adamgreig/agg-kicad/3d/J1011F01PNL_3D.STEP

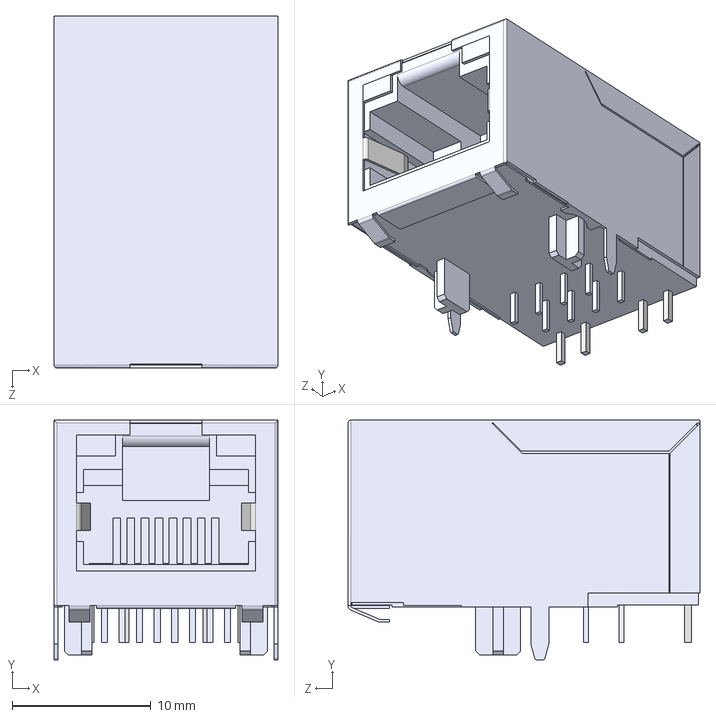
[picture p1: CAD file, 2024-02-22]
3d/J1011F01PNL_3D.STEP
16.2 x 17.3 x 25.4 mm
