adamgreig/agg-kicad/(threads)

Thread 1 (2015-11-08):

Add basic symbols

adamgreig, 2015-11-08:
Add basic commonly used symbols
 - [x] Power nets
 - [x] RCLs
 - [x] LEDs
 - [x] Xtals
 - [x] Range of connectors

Closed 2015-12-24.

Thread 3 (2015-11-08):

Ensure all footprints follow standard conventions

adamgreig, 2015-11-08:

seppestas, 2019-05-28:
Maybe it's interesting to look into the KLC (KiCad Library Convention). There is tools to check for it here: https://github.com/KiCad/kicad-library-utils

Thread 6 (2015-12-22):

Autogenerate HTML/MD table of parts

adamgreig, 2015-12-22:
Instead of current manually edited READMEs, generate a nice HTML or Markdown page with...

* All parts, categorised
* Details such as name, designator, footprint, order code
* Results of error checker (should all be ticks of course!)
* Notes currently in README including if it's been checked in production
* Description from .dcm file perhaps

Thread 17 (2016-01-03):

USB connector

adamgreig, 2016-01-03:
* Find a better way to do the shield pins so they don't want to be connected together
* Try swapping to plated slots for the side mounts
* Remove side pads from bottom mask layer
* Update to MOLEX's revised recommended footprint

adamgreig, 2016-01-03:
Only one shield pin now on the net by default. Most of the time this is fine (the pins are all connected on the component so only attaching at one point is fine anyway; you can edit the pin nets in the PCB if needed also).

Plated slots done. Hope they work.

Side pads now plated slots so not on bottom mask anywhere except where they must be.

Updated to revised footprint.

Closed 2016-01-03.

Thread 18 (2016-01-07):

Have panelise add extras

adamgreig, 2016-01-07:
* Tabs connecting step-repeated boards
* Panel outline
* Panel tooling holes
* Those weird calibration strip things?
* Alignment targets

Thread 21 (2016-01-24):

Create a label BoM

adamgreig, 2016-01-24:
Create print-out stickers for each bag of parts that show the designators, footprint/part/etc, and a drawing of the PCB with the placement (inc pin1) highlighted. Would make assembly much more convenient!

adamgreig, 2016-02-06:
Done! :tada:

Closed 2016-02-06.

Thread 30 (2016-02-08):

StickerBOM doesn't support circular PCBs on Edge.Cuts

adamgreig, 2016-02-08:

Closed 2016-02-08.

Thread 34 (2016-02-08):

agg-kicad.pro build problem on Windows

Wizongod, 2016-02-08:
The Library paths in agg-kicad.pro have Windows' back-slashes `\` mixed in instead of the normal slashes `/`. This also results in a problem when opening up in KiCad.

Closed 2016-02-08.

Thread 36 (2016-02-13):

Create incomplete outputs

ok1hra, 2016-02-13:
Error messages:
Traceback (most recent call last):
  File "/home/dan/kicad/agg-kicad-master/scripts/stickerbom.py", line 454, in <module>
    main(xmlpath, pdfpath)
  File "/home/dan/kicad/agg-kicad-master/scripts/stickerbom.py", line 446, in main
    label_height-14, line.refs)
  File "/home/dan/kicad/agg-kicad-master/scripts/stickerbom.py", line 208, in render
    scale_x = max_w / bound_width
ZeroDivisionError: float division by zero

[bd.pdf](https://github.com/adamgreig/agg-kicad/files/128887/bd.pdf)

adamgreig, 2016-02-13:
Do you have an example file that's causing this problem? My guess is it's finding the required bounding area around components is zero width, causing problems.

ok1hra, 2016-02-13:
if anything is missing, i add

[bd.zip](https://github.com/adamgreig/agg-kicad/files/128890/bd.zip)

adamgreig, 2016-03-12:
Hi @ok1hra, thanks for the bug report! I'm sorry it took a while to get around to fixing it. The problem was that P13 has just the one pad, and when its extent was computed, the pad's size was not taken into account, so it had a zero-sized highlight area, which caused the problem.

I've updated StickerBOM to include the size of the pads when computing the extents, so the problem should now be fixed - and seems to work fine on your PCB.

ok1hra, 2016-03-17:
Thanks for fix it, now generate without errors.
But otputs pile up in one page [bd.pdf](https://github.com/adamgreig/agg-kicad/files/177464/bd.pdf).

adamgreig, 2016-03-17:
Please try with `python3` instead of `python`, sounds like you are experiencing issue #45

ok1hra, 2016-03-18:
Confirming you're right, now works correctly, thanks again.

Closed 2016-03-12.

Thread 44 (2016-03-10):

sexp not behaving well

cchamilt, 2016-03-10:
```
Traceback (most recent call last):
  File "agg-kicad/scripts/stickerbom.py", line 454, in <module>
    main(xmlpath, pdfpath)
  File "agg-kicad/scripts/stickerbom.py", line 429, in main
    pcb = PCB(sexp.parse(f.read()))
  File "agg-kicad/scripts/stickerbom.py", line 185, in __init__
    self._parse(board)
  File "agg-kicad/scripts/stickerbom.py", line 296, in _parse
    self.modules.append(Module(module))
  File "agg-kicad/scripts/stickerbom.py", line 47, in __init__
    self._parse(mod)
  File "agg-kicad/scripts/stickerbom.py", line 126, in _parse
    self._parse_pad(pad)
  File "agg-kicad/scripts/stickerbom.py", line 151, in _parse_pad
    layers = sexp.find(pad, "layers")[1]
IndexError: list index out of range
```
When I wrap  sexp.find(pad, "layers") usage with a len check, I get a blank 11 page pdf.

adamgreig, 2016-03-10:
Do you have an example .kicad_pcb file that triggers this behaviour?

cchamilt, 2016-03-11:
For this project it would require an NDA as the design isn't mine to share.  Would that be OK?

adamgreig, 2016-03-12:
That is OK if necessary, though if you can isolate what's causing the problem perhaps that would be easier. Could you try adding `print(pad)` to the top of `_parse_pad` and see what the output is? It looks like probably one of the pads in your board does not have _any_ layers which is a bit unusual so might be a parsing issue.

cchamilt, 2016-03-12:
Ah, OK.  I would guess there are some old patterns with through-holes that were set to no layers instead of npth.  I'll add the print and review them.  Hopefully that is the fix.

cchamilt, 2016-03-13:
I went through and located the bad npth.  So everything has layers and the script finishes, but still seems that the pdf is blank.  I'll get you a copy of the NDA asap.

adamgreig, 2016-03-13:
Okay, thanks. Crashing with no layers is obviously still a bug but good to
know that was the cause of the exception.

Are you using Python 2 and if so could you try with Python 3? Should work
with both but is the root of another pdf rendering bug I'm chasing down.

cchamilt, 2016-03-19:
Yeah, I can confirm it doesn't render in either version of python.

Thread 45 (2016-03-11):

StickerBOM disagrees with Teapot

cillian64, 2016-03-11:
StickerBOM does terrible things when exposed to [my "teapot" board](https://github.com/cillian64/teapot/tree/master/board) - it seems like p1 of the output gets moved to and overlayed onto p2.

adamgreig, 2016-03-12:
Works fine in Python 3, issue seems to be in Python 2. Can't spot any obvious issue...

ch-aurich, 2016-03-26:
the problem is the way you generate the label positions... I added some debug outputs to see what happens in my script (until now I added the stickerbom feature only to the development branch: https://github.com/I2SE/eagle-bom.py/tree/develop):

python2 first generates all label positions in function sheet_positions (is initiated by function "zip") and then adds content to them... python3 initiates the generation of the label positions when they are used.

I will try to fix this issue in my script and then will suggest the solution to you as a pull request.

adamgreig, 2016-03-26:
ah, of course, thanks! I think just swapping to the generator zip in `itertools.izip` should solve it.

ch-aurich, 2016-03-27:
just using itertools.izip did not work for me with python 3.x therefore I implemented it a bit different... you can have a look at http://codereview.stackexchange.com/questions/26271/cleaner-way-to-import-izip-for-different-versions-of-python where I found this solution to be the most elegant...

adamgreig, 2016-03-27:
Fixed by #46

Closed 2016-03-27.

Thread 58 (2016-06-18):

3D Models

HarkonenBade, 2016-06-18:
Would it be possible to either add 3D models for parts, or at least for standard things like 0603/1206 style packages to reference the standard kicad library models for those parts?

adamgreig, 2016-06-18:
It would be really nice! I'm holding out on KiCAD supporting more 3d formats first, as the current format is a quite weird Wings3D thing whereas work is underway to support STL and other formats, at which point most parts can be downloaded from the manufacturer and the rest can be defined in text easily.

It might be relatively easy to refer to existing KiCAD 3d parts (eg an extra optional field in `build_mod_chip.py` and `build_mod_ic.py`) but I've not looked in to it yet...

HarkonenBade, 2016-07-11:
I've started collating some of my work on bits like this in https://github.com/HarkonenBade/kicad-models

Unfortunately I think until kicad supports more reasonable model formats, or someone writes a VRML exporter targeted at kicad, I don't think programmatic generation of models is going to be reasonable. Also I've been using openscad for a lot of stuff and really it needs better support for specifying colors/materials of objects.

So for now I would set this issue to awaiting upstream changes.

Thread 67 (2016-07-01):

Add an arg to which field to print instead of "supplier":"number"

metropt, 2016-07-01:
Hi,
Thank you for the work doing the script :)

I don't usually have the supplier on the part. Only the manf. part number which I call "manf#" because I use [KiCost](https://kicost.readthedocs.io/en/latest/readme.html) to generate the BOM with prices, etc...

So to use your code I needed to comment the condition on line 473 which works nice :) I would be able to create the PDF however the supplier field doesn't print the same value on all components but some random field.

It would be nice to be able to select the field you want to use.

I'll try to do that.

HarkonenBade, 2016-07-01:
You might want to take a look at #66

metropt, 2016-07-01:
Thank you, edited supplier_to_output and add only manf# solved my problem!

adamgreig, 2016-07-02:
Great, glad to hear you've worked it out. Once #66 lands you can do it from the command line in KiCAD without editing the script at all which will be nice.

Closed 2016-07-02.

Thread 77 (2016-09-18):

GitHub integration to show new symbols and footprints

adamgreig, 2016-09-18:
Make a neat service that sees new pull requests, notices if there are any new .yaml or .kicad_mod files, and if so, renders them and comments with a picture.

seppestas, 2019-05-28:
I was planning to add this sort of functionality to https://github.com/productize/kicad-file-render-service. Let me know if you are still interested in this use-case.

Thread 87 (2016-11-02):

microusb part has VCC as power input

cillian64, 2016-11-02:
The part is actually a microusb AB, where VCC could be a power input or output, so "passive" might be most correct.

Alternatively, since this part is almost always used as a type B in practice, power output would probably be the most helpful choice, and anybody actually using OTG can change it.

Closed 2016-11-07.

Thread 103 (2017-03-30):

TPS62152 PG should be open drain, not output

cillian64, 2017-03-30:
Causes ERC error when pulling PG to ground, as is recommended when PG is unused.

Closed 2017-03-30.

Thread 108 (2017-05-08):

Autogenerate mechanical holes and mounting holes

adamgreig, 2017-05-08:
Replace M2.5_HOLE, M2.5_MOUNT, M3_HOLE, and M3_MOUNT with autogenerated holes in a wider range of sizes and styles.

See #106 for earlier discussion.

Thread 121 (2017-08-22):

Don't store built artifacts in the repository

russss, 2017-08-22:
Dealing with multiple pull requests is rather a pain at the moment because pretty much all PRs include unmergeable changes to the `agg-kicad.[lib|pro]` files.

It would be much easier to deal with this stuff if these generated files weren't stored in the repo. Here's one way this could be done fairly easily:

* Alter the build scripts so that the generated libraries live in a separate directory tree.
* Either:
     * Manually tag a release periodically after merging PRs, or,
     * Make the travis script automatically tag a new release when a build succeeds on master.
* Set up travis so tag builds are [uploaded as GitHub releases](https://docs.travis-ci.com/user/deployment/releases/)

This means that the generated libraries can be downloaded as .zip files (which is probably more convenient for most users), and those who are working off the git tree won't be constantly plagued with merge conflicts.

adamgreig, 2017-08-22:
I'm not sure what the best way to deal with this is. Almost all of my own use cases, and many others I know about, have agg-kicad as a git submodule in their own repository, which makes it easy to keep up-to-date, but then they only use that submodule for the `agg.pretty` directory and `agg-kicad.lib` top level library that contains every part.

In addition to being annoying because those build artifacts change, a lot of users want some of the library parts (ICs etc) without others (the agg-kicad R, C, L, and power symbols). So there was some thought to having separate build artifacts for different collections.

I wonder if another repository that only contains up-to-date build artifacts is the way to go, automatically maintained by Travis?

HarkonenBade, 2017-08-22:
Yeah, I'd suspect that the best way to handle it is with one repo (say `agg-kicad-src`) that contains all the current code and yaml and a second repo (say `agg-kicad`) that contains only the built artifacts and is only ever pushed to by a travis script that runs on new commits to the master of the src repo.

seppestas, 2019-05-28:
I think using a second repo or maybe an orphaned brach to store the build results sounds like a good idea. This would also make it a bit easier / cleaner to include the build artifacts as a submodule.

Thread 138 (2019-05-02):

Generate sym-lib-table now that kicad doesn't use the .pro to list libraries

adamgreig, 2019-05-02:

Closed 2020-04-14.

Thread 141 (2019-11-25):

Recommended Practice - NC but groundable

HarkonenBade, 2019-11-25:
What should be the recommended practice for symbols that have pins which are officially declared as N/C but that the data sheet suggests may be grounded or left floating as desired?

HarkonenBade, 2019-11-26:
e.g. pins 3, 4 and 5 on the MCP1810 ( http://ww1.microchip.com/downloads/en/DeviceDoc/20005623A.pdf)

Thread 143 (2019-11-30):

3D models have all moved

russss, 2019-11-30:
Unless I'm completely mistaken, the 3D models we reference have moved locations in new(ish) versions of KiCAD... e.g.:

`Housings_SOIC.3dshapes` is now `Package_SO.3dshapes`
`Resistors_SMD.3dshapes` is now `Resistor_SMD.3dshapes`

But worse, the name of the actual files has also changed in many cases. This seems to have happened back in Feb 2018.

adamgreig, 2019-11-30:
Yep, it's pain... Most of them will have to be updated by hand I think. I'm also not convinced defaulting to resistors for all chip components is the best bet, but I don't really want to split each size into resistor vs capacitor footprints. On the other hand, maybe it would allow different silk for each and perhaps slightly different pad geometries...

Also, for a lot of parts there are no models in KiCAD itself, but there are manufacturer supplied models, which might be worth including in the repo.

adamgreig, 2019-11-30:
On the whole I think the project needs a bit of TLC; I still use it exclusively for all my PCB designs but my impression is that the stock KiCAD libraries are much higher quality today than when I started agg-kicad, so I think other people probably have less need for it. That said, I think the scripted symbol and footprint generation is still really useful. I wonder if it's worth rejigging to make it easier to use the generator scripts or generated parts individually (perhaps part of #121 or something), or something else.

HarkonenBade, 2019-12-01:
I'm still a big fan of the library in general and have been using it myself for a recent major project. I agree that the stock libraries seem to be improving dramatically, but I do find the scripted yaml generation to be the best way to throw together new parts quickly and accurately.
I'd be very in favour of seeing a setup where a given project has a single yaml (or maybe a small local directory of them) that can be run through a single script to generate a symbol library and footprint library of parts for that project. Particularly it might be interesting at looking at integrating the library and footprint generation. Given it's not entirely unusual to be generating new QFN/DFN variants for specific ICs, and it may be nice to be able to actively just place the footprint definition inside the library symbol definition for that specific part.

Also back on the models, I have some current updates that i can upstream to restore some of the models, and I had a little work on scripted model generation that was abandoned at the time due to kicad's limited model types support, but may now be worth renewing.

Gasman2014, 2019-12-01:
Would https://github.com/qeda/qeda be a suitable scriptable yaml generator?

Thread 148 (2022-10-18):

Does stickerbom work in KiCad 6.0?

Phozer, 2022-10-18:
First of all, great Project!

I tried using the stickerbom.py to create labels to stick on my component bags. I face some problems using it, so I want to ask if it even works with KiCad 6.0?

This is what i get as output.
```
python C:\03_Data\repos_external\git\agg-kicad\scripts\stickerbom.py C:\03_Data\repos\SVN\TestAutomation\TestAdapter\SNIFX\SNIFX.QP2\2_KiCad\SNIFX.xml C:\03_Data\repos\SVN\TestAutomation\TestAdapter\SNIFX\SNIFX.QP2\2_KiCad
Traceback (most recent call last):
  File "C:\03_Data\repos_external\git\agg-kicad\scripts\stickerbom.py", line 589, in <module>
    main()
  File "C:\03_Data\repos_external\git\agg-kicad\scripts\stickerbom.py", line 534, in main
    pcb = PCB(sexp.parse(f.read()))
  File "C:\03_Data\repos_external\git\agg-kicad\scripts\stickerbom.py", line 166, in __init__
    self._parse(board)
  File "C:\03_Data\repos_external\git\agg-kicad\scripts\stickerbom.py", line 306, in _parse
    min(m.at[0] for m in self.modules),
ValueError: min() arg is an empty sequence
```

adamgreig, 2022-10-18:
Thanks for opening the issue! It looks like KiCad 6 made a few changes that broke stickerbom, mostly renaming "modules" to "footprints" in the board file and changing how graphic arcs are represented from "centre, start, angle" to "centre, mid, end". I've just pushed an update to stickerbom that seems to work for me on some KiCad 6 boards, could you check if it works for you?

Phozer, 2022-10-19:
Thanks for your quick fix.
Seems to work much better than before.
Now i have this issue:
```
C:\03_Data\repos_external\git\agg-kicad\scripts>python stickerbom.py C:\03_Data\repos\SVN\TestAutomation\TestAdapter\SNIFX\SNIFX.QP2\2_KiCad\SNIFX.xml C:\03_Data\repos\SVN\TestAutomation\TestAdapter\SNIFX\SNIFX.QP2\2_KiCad\stickerBOM.pdf
Traceback (most recent call last):
  File "C:\03_Data\repos_external\git\agg-kicad\scripts\stickerbom.py", line 600, in <module>
    main()
  File "C:\03_Data\repos_external\git\agg-kicad\scripts\stickerbom.py", line 596, in main
    cr.show_page()
__main__.cairo.MemoryError: out of memory
```
I tried with different boards. A PDF gets created but it's blank.

adamgreig, 2022-10-19:
Hm, that's odd. It seems like this might be an issue with PyCairo on Windows, see https://github.com/pygobject/pycairo/issues/239. Perhaps you could try the builds linked there, or a Linux/WSL build?

Phozer, 2022-12-05:
Do you have e public project which worked for you? Then I can check for differences and troubleshoot. Would love to get this to work.

Phozer, 2022-12-06:
Is there an option to uses the copper layer instead of the fab layer for the drawings?

adamgreig, 2022-12-08:
Ah cool, glad you figured it out! There's not a built-in option at the moment, but if you change `F.Fab` for `F.Cu` and `B.Fab` for `B.Cu` on lines 579-593 that should do it; currently it uses F.Fab first but if a footprint doesn't have any items on the fab layer it will instead render use the copper and silkscreen layers.

Phozer, 2022-12-16:
I will now close this Issue because for me it's fixed now. I just noticed that my Board outline did not get drawn. Just if you bother you may fix that. Thanks for your work. It helped a lot.

adamgreig, 2022-12-19:
Thanks for sticking with it, I'm glad it's working for you now! Not sure what's up with the board outline, I'll try and look into it.

Closed 2022-12-16.
