adamgreig/agg-kicad/mod/ic/msop-8-ep-ad.yaml

chip_shape: [3.1, 3.1]
description: |-
  MSOP-8 from JEDEC MO-187-AA-T, with EP, AD specific RH-8-1
  IPC-7351B: SOP65P490X110-9N
ep_shape: [1.725, 1.66]
ep_vias: [0.3, 0.65, 0.3]
model:
  offset: [0, 0, 0]
  path: ${KICAD8_3DMODEL_DIR}/Package_SO.3dshapes/MSOP-8_3x3mm_P0.65mm.step
  rotate: [0, 0, 0]
  scale: [1, 1, 1]
name: MSOP-8-EP-AD
pad_shape: [1.45, 0.45]
pin_pitch: 0.65
pin_shape: [1.0, 0.38]
pins: 8
row_pitch: 4.4
rows: 2
