adamgreig/agg-kicad/mod/ic/msop-8-ep-ltc.yaml

chip_shape: [3.1, 3.1]
description: |-
  MSOP-8 from JEDEC MO-187-AA-T, with EP, LT DWG 05-08-1662
  IPC-7351B: SOP65P490X110-9N
model:
  offset: [0, 0, 0]
  path: ${KICAD8_3DMODEL_DIR}/Package_SO.3dshapes/MSOP-8_3x3mm_P0.65mm.step
  rotate: [0, 0, 0]
  scale: [1, 1, 1]
ep_shape: [1.68, 1.88]
name: MSOP-8-EP-LTC
pad_shape: [1.2, 0.42]
pin_pitch: 0.65
pin_shape: [0.8, 0.38]
pins: 8
row_pitch: 4.4
rows: 2
