adamgreig/agg-kicad/mod/ic/qfn-16-ep-nxp.yaml

chip_shape: [3.0, 3.0]
description: |-
  HVQFN-16 from PCAL9538A
  IPC-7351B: QFN50P300X300X100-17N
ep_paste_shape: [0.3, 0.3, 0.31, 0.31]
ep_shape: [1.5, 1.5]
model:
  offset: [0, 0, 0]
  path: ${KICAD8_3DMODEL_DIR}/Package_DFN_QFN.3dshapes/QFN-16-1EP_3x3mm_P0.5mm_EP1.7x1.7mm.step
  rotate: [0, 0, 0]
  scale: [1, 1, 1]
name: QFN-16-EP-NXP
pad_shape: [0.9, 0.24]
pin_pitch: 0.5
pin_shape: [-0.4, 0.24]
pins: 16
row_pitch: 3.1
rows: 4
