adamgreig/agg-kicad/mod/ic/qfn-16-ep-skyworks.yaml

chip_shape: [3.0, 3.0]
description: |-
  QFN-16 from SKY65111-348LF datasheet
  For SKY65111-348LF
  IPC-7351B: QFN50P300X300X100-16N
ep_paste_shape: [0.7, 0.7, 0.3, 0.3]
ep_shape: [1.78, 1.78]
ep_vias: [0.3, 0.4, 0.2]
model:
  offset: [0, 0, 0]
  path: ${KICAD8_3DMODEL_DIR}/Package_DFN_QFN.3dshapes/QFN-16-1EP_3x3mm_P0.5mm_EP1.7x1.7mm.step
  rotate: [0, 0, 0]
  scale: [1, 1, 1]
name: QFN-16-EP-SKYWORKS
pad_shape: [0.78, 0.26]
pin_pitch: 0.5
pin_shape: [-0.3, 0.25]
pins: 16
row_pitch: 2.86
rows: 4
