adamgreig/agg-kicad/mod/ic/qfn-24-ep-max.yaml

chip_shape: [4.0, 4.0]
description: |-
  QFN-24 from MAXIM. Doc no. 21-0139
  For MAX17435
ep_mask_shape: [0.9, 0.9, 0.4, 0.4]
ep_paste_shape: [0.9, 0.9, 0.4, 0.4]
ep_shape: [2.6, 2.6]
model:
  offset: [0, 0, 0]
  path: ${KICAD8_3DMODEL_DIR}/Package_DFN_QFN.3dshapes/QFN-24_4x4mm_P0.5mm.step
  rotate: [0, 0, 0]
  scale: [1, 1, 1]
name: QFN-24-EP-MAX
pad_shape: [0.8, 0.3]
pin_pitch: 0.5
pin_shape: [-0.4, 0.23]
pins: 24
row_pitch: 3.91
rows: 4
