adamgreig/agg-kicad/mod/ic/qfn-24-ep-micrel.yaml

chip_shape: [4.0, 4.0]
description: |-
  QFN-24 from KSZ8081RNx datasheet
  For KSZ8081RNx
ep_mask_shape: [1.0, 1.0, 0.2, 0.2]
ep_paste_shape: [1.0, 1.0, 0.2, 0.2]
ep_shape: [2.6, 2.6]
ep_vias: [0.35, 0.5, 0.7]
name: QFN-24-EP-MICREL
pad_shape: [0.48, 0.23]
pin_pitch: 0.5
pin_shape: [-0.4, 0.25]
pins: 24
row_pitch: 3.72
rows: 4
model:
  offset: [0, 0, 0]
  path: ${KICAD8_3DMODEL_DIR}/Package_DFN_QFN.3dshapes/QFN-24_4x4mm_P0.5mm.step
  rotate: [0, 0, 0]
  scale: [1, 1, 1]
