adamgreig/agg-kicad/mod/ic/qfn-32-bgt24mtr.yaml

chip_shape: [4.5, 5.5]
description: VQFN32-9 for Infineon BGT24MTR family
ep_paste_shape: [1, 1, 0.5, 0.5]
ep_shape: [2.9, 3.9]
ep_vias: [0.3, 0.6, 0.7]
name: QFN-32-BGT24MTR
pad_shape: [0.85, 0.3]
pin_pitch: 0.5
pin_shape: [-0.55, 0.25]
pins: 32
pins_first_row: 10
row_pitch: [4.15, 5.15]
rows: 4
model:
  offset: [0, 0, 0]
  path: ${KICAD8_3DMODEL_DIR}/Package_DFN_QFN.3dshapes/QFN-32-1EP_5x5mm_P0.5mm_EP3.3x3.3mm.step
  rotate: [0, 0, 0]
  scale: [1, 1, 1]
