adamgreig/agg-kicad/mod/ic/qfn-32-ep-ti.yaml

chip_shape: [5.0, 5.0]
description: |-
  VQFN-32 from BQ40Z60
  IPC-7351B: QFN50P500X500X100-33N
ep_mask_shape: [3.45, 3.45, 0, 0]
ep_paste_shape: [1.45, 1.45, 0.3, 0.3]
ep_shape: [3.45, 3.45]
ep_vias: [0.3, 0.4, 1.0]
model:
  offset: [0, 0, 0]
  path: ${KICAD8_3DMODEL_DIR}/Package_DFN_QFN.3dshapes/QFN-32-1EP_5x5mm_P0.5mm_EP3.3x3.3mm.step
  rotate: [0, 0, 0]
  scale: [1, 1, 1]
name: QFN-32-EP-TI
pad_shape: [0.85, 0.28]
pin_pitch: 0.5
pin_shape: [-0.4, 0.25]
pins: 32
row_pitch: 4.95
rows: 4
