adamgreig/agg-kicad/mod/ic/sc-70-6.yaml

chip_shape: [1.4, 2.15]
description: |-
  SC-70-6
  JEDEC MO-203-AB
  IPC-7351B: SOT65P210X110-6N
model:
  offset: [0, 0, 0]
  path: ${KICAD8_3DMODEL_DIR}/Package_TO_SOT_SMD.3dshapes/SOT-363_SC-70-6.step
  rotate: [0, 0, 90]
  scale: [1, 1, 1]
name: SC-70-6
pad_shape: [0.95, 0.4]
pin_pitch: 0.65
pin_shape: [0.5, 0.3]
pins: 6
row_pitch: 2.2
rows: 2
