adamgreig/agg-kicad/mod/ic/soic-8-ep.yaml

chip_shape: [4.0, 5.0]
description: |-
  SOIC-8 from JEDEC MS-012AA, with exposed pad
  IPC-7351B: SOIC127P600X175-8N
ep_shape: [2.4, 3.1]
ep_vias: [0.3, 0.65, 0.3]
model:
  offset: [0, 0, 0]
  path: ${KICAD8_3DMODEL_DIR}/Package_SO.3dshapes/SOIC-8_3.9x4.9mm_P1.27mm.step
  rotate: [0, 0, 0]
  scale: [1, 1, 1]
name: SOIC-8-EP
pad_shape: [1.55, 0.6]
pin_pitch: 1.27
pin_shape: [1.1, 0.5]
pins: 8
row_pitch: 5.4
rows: 2
