adamgreig/agg-kicad/mod/ic/sot-323.yaml

chip_shape: [1.35, 2.1]
description: |-
  SOT-323
  IPC-7351B: SOT65P210X110-3N
model:
  offset: [0, 0, 0]
  path: ${KICAD8_3DMODEL_DIR}/Package_TO_SOT_SMD.3dshapes/SOT-323_SC-70.step
  rotate: [0, 0, -90]
  scale: [0.4, 0.4, 0.4]
name: SOT-323
pad_shape: [0.85, 0.55]
pin_pitch: 0.65
pin_shape: [0.4, 0.3]
pins: 6
row_pitch: 2.1
rows: 2
skip_pins: [2, 4, 6]
