adamgreig/agg-kicad/mod/ic/sot-666.yaml

chip_shape: [1.3, 1.7]
description: |-
  SOT-666
  IPC-7351B: SOTFL50P162X60-6N
  AKA SOT-563
  AKA SC-75-6
  AKA SC-89-6
name: SOT-666
pad_shape: [0.71, 0.3]
pin_pitch: 0.5
pin_shape: [0.35, 0.25]
pins: 6
row_pitch: 1.44
rows: 2
model:
  offset: [0, 0, 0]
  path: ${KICAD8_3DMODEL_DIR}/Package_TO_SOT_SMD.3dshapes/SOT-666.step
  rotate: [0, 0, 0]
  scale: [1, 1, 1]
