adamgreig/agg-kicad/mod/ic/tssop-14.yaml

chip_shape: [4.5, 5.1]
description: |-
  TSSOP-14 from JEDEC MO-153
  IPC-7351B: SOP65P640X120-14N
model:
  offset: [0, 0, 0]
  path: ${KICAD8_3DMODEL_DIR}/Package_SO.3dshapes/TSSOP-14_4.4x5mm_P0.65mm.step
  rotate: [0, 0, 0]
  scale: [1, 1, 1]
name: TSSOP-14
pad_shape: [1.35, 0.45]
pin_pitch: 0.65
pin_shape: [0.95, 0.3]
pins: 14
row_pitch: 5.75
rows: 2
