adamgreig/agg-kicad/mod/ic/tssop-20-ep.yaml

chip_shape: [4.5, 6.6]
description: |-
  TSSOP-20 from JEDEC MO-153AC with EP per LT3751
  IPC-7351B: SOP65P640X120-21N
ep_mask_shape: [2.2, 1.5, 0.0, 0.5]
ep_paste_shape: [2.2, 1.5, 0.0, 0.5]
ep_shape: [2.74, 3.86]
ep_vias: [0.4, 0.6, 0.5]
model:
  offset: [0, 0, 0]
  path: ${KICAD8_3DMODEL_DIR}/Package_SO.3dshapes/TSSOP-20_4.4x5mm_P0.5mm.step
  rotate: [0, 0, 0]
  scale: [1, 1, 1]
name: TSSOP-20-EP
pad_shape: [1.35, 0.45]
pin_pitch: 0.65
pin_shape: [0.95, 0.3]
pins: 20
row_pitch: 5.75
rows: 2
