adamgreig/agg-kicad/mod/ic/dfn-10-ep-max.yaml

chip_shape: [3.0, 3.0]
description: |-
  DFN-10 with EP
  For MAX5969x
ep_paste_shape: [1.2, 0.8, 0, 0.4]
ep_shape: [1.58, 2.35]
model:
  offset: [0, 0, 0]
  path: ${KISYS3DMOD}/Housings_DFN_QFN.3dshapes/DFN-10-1EP_3x3mm_Pitch0.5mm.wrl
  rotate: [0, 0, 0]
  scale: [1, 1, 1]
name: DFN-10-EP-MAX
pad_shape: [0.7, 0.3]
pin_pitch: 0.5
pin_shape: [-0.4, 0.25]
pins: 10
row_pitch: 2.95
rows: 2
