adamgreig/agg-kicad/mod/ic/dfn-16-ep-ltc-de.yaml

chip_shape: [3.1, 4.1]
description: |-
  DFN-16 from LTC4353
  IPC-7351B: DFN45P300X400X75-17N
ep_mask_shape: [0.8, 0.8, 0.2, 0.4]
ep_paste_shape: [0.8, 0.8, 0.2, 0.4]
ep_shape: [1.7, 3.3]
model:
  offset: [0, 0, 0]
  path: ${KISYS3DMOD}/Housings_DFN_QFN.3dshapes/DFN-16-1EP_3x4mm_Pitch0.45mm.wrl
  rotate: [0, 0, 0]
  scale: [1, 1, 1]
name: DFN-16-EP-LTC-DE
pad_shape: [0.7, 0.25]
pin_pitch: 0.45
pin_shape: [-0.41, 0.28]
pins: 16
row_pitch: 2.9
rows: 2
