adamgreig/agg-kicad/mod/ic/dfn-8-ep-ad.yaml

chip_shape: [3.1, 3.1]
description: |-
  DFN-8
  IPC-7351B: DFN50P300X300X75-9N
ep_mask_shape: [0.8, 0.8, 0, 0.4]
ep_paste_shape: [0.8, 0.8, 0, 0.4]
ep_shape: [1.8, 2.5]
model:
  offset: [0, 0, 0]
  path: ${KISYS3DMOD}/Housings_DFN_QFN.3dshapes/DFN-8-1EP_3x3mm_Pitch0.5mm.wrl
  rotate: [0, 0, 0]
  scale: [1, 1, 1]
name: DFN-8-EP-AD
pad_shape: [0.65, 0.35]
pin_pitch: 0.5
pin_shape: [-0.5, 0.3]
pins: 8
row_pitch: 3.1
rows: 2
