adamgreig/agg-kicad/mod/ic/dfn-8-ep-microchip.yaml

chip_shape: [3.1, 3.1]
description: |-
  DFN-8
  IPC-7351B: DFN65P300X300X90-9N
ep_mask_shape: [0.8, 0.8, 0, 0.4]
ep_paste_shape: [0.8, 0.8, 0, 0.4]
ep_shape: [1.55, 2.4]
model:
  offset: [0, 0, 0]
  path: ${KISYS3DMOD}/Housings_DFN_QFN.3dshapes/DFN-8-1EP_3x3mm_Pitch0.65mm.wrl
  rotate: [0, 0, 0]
  scale: [1, 1, 1]
name: DFN-8-EP-MICROCHIP
pad_shape: [0.65, 0.35]
pin_pitch: 0.65
pin_shape: [-0.3, 0.3]
pins: 8
row_pitch: 3.1
rows: 2
