adamgreig/agg-kicad/(commit log)

2015-11-08 Initial commit.
    Add a bunch of library schematic symbols from various projects, mostly not
    yet standardised. Add desired standards too.
2015-11-08 Add my glut of old footprints. Still require standardising and dealing with C/R/L 0402/0603/0805.
2015-11-08 Standardise connectors library
2015-12-21 add compilelib.py and overall agg-kicad.lib file
2015-12-22 add connectorlib.py to autogenerate connectors
2015-12-22 first go at automatic schematic symbol checking
2015-12-22 consistant and useful naming scheme for STM32 parts
2015-12-22 fix pin grid on adum1201
2015-12-22 fix u.fl connector
2015-12-22 draw ESD diode filled-in
2015-12-22 Enforce no missing numbers in pin numbering sequence
2015-12-22 Rebuild connector library on latest git version
2015-12-22 Rebuild agg-kicad from latest git version
2015-12-23 have travis verify agg-kicad.lib is up-to-date
2015-12-23 rebuild agg-kicad.lib (hi travis)
2015-12-23 further updates to agg-kicad.lib building...
2015-12-23 rebuild agg-kicad.lib (hi again travis..)
2015-12-24 Add LED symbol
2015-12-24 Add GND symbols
2015-12-24 Swap to using new powerlib.py to generate power symbols
2015-12-25 Add generic diode
2015-12-26 Add MicroUSB connector
2015-12-26 Rebuild agg-kicad.lib
2015-12-26 Add PWR power flag
2015-12-27 Move old not-yet-tested footprints into unchecked.pretty
2015-12-27 Add 0201, 0402, 0603, 0805, and 1206 footprints.
2015-12-27 Add LED0603 footprint
2015-12-27 Clarify footprint rules
2015-12-27 Rework silkscreen on 0201..1206 devices
2015-12-27 Add M3 hole and mounting hole
2015-12-27 Allow hidden ref/val and hide those of M3 hole/mount
2015-12-27 Add new USB connector
2015-12-27 Add new auto-generated SOIC and MSOP footprints
2015-12-28 Update IC footprints for IPC-7351B compliance
2015-12-28 icmod: only save changed footprints
2015-12-28 Add support for EP vias in footprints (and add to UBX)
2015-12-28 Fix inconsistent arc on MICROSD footprint
2015-12-29 Support drawing drills and offsets and paste/mask margins
2015-12-29 Refactor out kicad_mod.py; Add first chipmod.py
2015-12-30 New chip passive footprints that are IPC-7351B compliant.
2015-12-30 Add 0805-LED
2015-12-30 Fix GND symbols in power.lib
2015-12-31 add STM32F091RxHx and corresponding UFBGA-64
2015-12-31 Add TC2030-NL footprint
2015-12-31 Fix incorrect BOOT0 pin name in STM32F091RxHx
2015-12-31 Update README for STM32F091RxHx
2015-12-31 Add WIREPAD
2016-01-01 Update footprint/datasheet fields to correct font size and invisibility. Closes #10
2016-01-02 Add surface-mount side-entry JST PA
2016-01-03 Give JST-PA SMT parts oval mounting holes
2016-01-07 Add STM32L4xxJxYx
2016-01-07 Fix width bug in iclib which will probably some breakage. Adds STM32F4xxZxJz.
2016-01-07 Add footprint for MPU-9250
2016-01-07 Fix up symbols that referred to 'PAD' and old footprint names
2016-01-08 Add ELLVGG footprint
2016-01-09 Add TCXO symbol and TG-5006CG footprint
2016-01-09 Add KSSG13J12-N magnetic buzzer
2016-01-10 Add PULSE_32x100 chip antenna footprint
2016-01-11 fix footprint reference in stm32f4xxzxjz
2016-01-12 add more connector symbols
2016-01-12 Add connectors up to 20 and 18 pin 1.27mm SIL
2016-01-16 Fix GND pad on PULSE antenna package
2016-01-16 Remove EP for MPU-9250 as it should not be soldered (!)
2016-01-24 Move agg-kicad.lib to root directory [BREAKING]
2016-02-01 Include footprint and datasheet fields in conn.lib. Closes #19
2016-02-01 Add top-smd JST PA connectors. Closes #26.
2016-02-02 Fix all outdated footprint references. Closes #24
2016-02-03 Add STM32F411CxUx
2016-02-03 add TFML and SFML footprint script
2016-02-04 Add STM32F405RxTx and ADL5324
2016-02-05 add first go at pcb-to-svg
2016-02-06 Display just footprint name, not footprint library name
2016-02-08 Add LTC4353 part and DFN-16-EP-LTC-DE footprint
2016-02-08 Fix DFN-16 footprint size
2016-02-08 Added in MAX17435, a multi-chemistry battery charger that communicates on SMBus. (symbol & footprint)
2016-02-08 Corrected pin numbering error.
2016-02-08 updated the agg-kicad.pro file
2016-02-08 Temporary fix for agg-kicad.pro build on windows
2016-02-08 Replace backslashes with forward slashes in agg-kicad.pro
    Fixes #34.
    This is not really nice - ideally we would use os.path somehow or other - but
    is the quickest and simplest way to resolve the problem on Windows. Will
    revisit if it becomes a problem again.
2016-02-11 Add SPDT switch
2016-02-11 Add 24AA01 I2C EEPROM schematic
2016-02-16 add SIL/DIL 2.54mm headers
2016-02-17 Add PCS9502 I2C Port Expander symbol and footprint
2016-02-29 Add TYS5040 and SRP5030T inductor footprints
2016-03-04 Add LTC4151 schematic symbol
2016-03-06 Added in footprints for power transistors, schematic symbol for totem pole NMOS, and extra power VSHORE.
2016-03-06 Rebuilt agg-kicad.lib and .pro files due to earlier rebase fail.
2016-03-06 Added in Farnell number and footprint for NMOS totem pole schematic symbol.
2016-03-07 Fix pin directions on PCA9502, Fix pad size on HVQFN24 footprint
2016-03-08 Renamed back to SON2x2 (see comments). Added VML1006 transistor footprint. Centred PowerPAK-SO-8.
2016-03-08 Added generic dual N-MOSFET symbol.
2016-03-09 Added TPS62152 3.3V 1A fixed buck converter. Added inductor footprint. Corrected minor PCAL9538 errors. Updated README.md.
2016-03-09 Add 1210 footprint
2016-03-09 Include built 1210 footprint (oops)
2016-03-11 Added some pin 1 indicators for footprints, removed some.
2016-03-11 Changed pin to 'passive' from 'unspec' in TPS62152. Corrected reference to PowerPair-3x3 for SiZ340dt.
2016-03-27 make all CHIP GNDs PWRINs
2016-03-27 Shift connector on ADIS16405BMLZ slightly
2016-03-28 Tweak ADIS16405BMLZ more: use AD spacing for mounting holes and distance to connector
2016-04-12 fix lib parts that had a footprint without library
2016-04-15 Add STM32F042FxP6
2016-04-15 Tweak component and pin naming
2016-05-01 usb connectors are P? not IC?
2016-05-01 make UCS1002 VBUS2 passive so it can be wired to VBUS1
2016-05-08 Add SFM-110-02-L-DH footprint
2016-05-10 Add TFML-110-01-L-D-RA footprint
2016-05-15 Increase pad copper size, fix silkscreen on SFM part
2016-05-23 Minor change to PowerPAK-SO-8 to conform to recommended Vishay footprint
2016-05-29 Add XTAL-25x20 footprint
2016-05-30 Fix incorrect pwrout gnd pin on rfm69
2016-06-14 remove debug print
2016-06-16 Added STM32F0xxKxTx
2016-06-16 Removed (missing) footprint from STM32F0xxKxTx
2016-06-16 Added STM32F0xxKxUx part
2016-06-16 Added AM26C31 quad RS422 driver
2016-06-16 Added LQFP-32, assigned to STM32F0xxKxTx
2016-06-17 Added STM32F0xxCxUx in existing UFQFPN-48
2016-06-18 Reference standard kicad 3d models
    Adds standard library kicad 3D models for mod_chip parts.
2016-06-25 compute PCB bounds ourselves instead of relying on what the file says
2016-06-25 Add SM{A,B,C} Packages
    Adds SMA, SMB and SMC diode packages, based on the package and land
    references supplied by Diodes Inc.
2016-06-27 Improved STM32F0xxCxUx datasheet URL
2016-06-27 Made AM26C31 part pin order more sensible
2016-06-27 Actually update footprint from last
2016-07-03 Switch suppliers over to comma seperated list
2016-07-17 Added US8-3.1mm package
    Added US8 JEDEC MO-187-CA 3.1mm variant
    Doc: https://www.jedec.org/standards-documents/docs/mo-187-f
2016-09-18 Avoid confusing error with pins on only one side
    Previously if an IC schematic symbol only had pins on one side,
    build_lib_ic.py would fail to index producing a confusing error. This
    change intercepts this problem and produces a more helpful error.
2016-09-18 Added QFN-24-EP-MICREL fp for KSZ8081RNx
    Also updated the pin number from PAD to EP in the schematic part to
    match the footprint.
2016-09-18 Swapped sides of power and data pins on 25aa02 part
2016-09-18 749010012A ethernet magnetics part and fp
2016-09-21 max17503 buck switcher
2016-10-02 Added TPS92512 CC buck in MSOP-10-EP-TI
2016-10-14 Added BQ24232HA lipo charger IC
2016-10-15 Made BQ24232HA pin order a bit more helpful
2016-11-07 Update microUSB symboi: VCC to Power Out, Shield to Passive. Closes #87
2016-12-09 add resistor divider symbol
2016-12-09 add r1/r2 labels to resistor divider symbol
2016-12-13 Add ER-TFT024-3 TFT screen, ER-CON50HT-1 connector, LQFP144 package, STM32F7xxZxTx IC
2016-12-13 Update LEDK4 pin on ER-TFT024-3
2016-12-14 update footprint for tpa301
2016-12-14 SWD RST to OD, ER-TFT024-3 LED pins to passive
2016-12-14 ER-TFT024-3 GND pins to pwrin...
2016-12-14 Fix STM32F7xxZxTx pin directions
2016-12-14 update pin directions on EF-TFT024-3 and AR1021
2016-12-14 add B32921 x2/y2 cap footprint
2016-12-15 fix rjhse-538x pin assignment..
2017-01-03 Fix BQ40Z60 pin ordering on schematic
2017-01-03 Fix BQ40Z60 footprint
2017-01-04 Fix dimensions of footprint
2017-01-10 Add SON2x2N NFET footprint
2017-02-09 Added max17521 quad el driver, minus farnell part
    Farnell's down, will add part number when it comes back
2017-02-20 Added NPIC6C596A open drain power shift register
2017-02-26 Add LTC2975 schematic and QFN-64-EP-LTC-UP footprint
2017-02-27 Add tps62132 and tps62133 schematic symbols
2017-02-27 Correct some pin modes
2017-02-27 Fix pin modes in tps62152
2017-02-28 Add XFL4020 footprint
2017-03-01 Update DCM format to use two spaces instead of a tab, otherwise latest kicad baulks out
2017-04-19 Symbol for 4-pin crystal oscillator parts and some footprints
    Currently we have symbols for TCXO (4 pins with one NC) and
    TCXO_EN (which has 6 pins).
    It seems like a the most common oscillator footprint is a 4-pin
    package where pin 1 is either EN/enable or VC/voltage control,
    and this is common amongst SPXO/TCXO/VCXO components.
    So it seems worthwhile having a generic oscillator part.
    (Also added some footprints for Seiko Epson SPXOs.)
2017-04-25 Add Raspberry Pi symbol
2017-05-06 Raspberry Pi Footprints
    This adds the following:
    * PCB templates for the full-blown RPi hat spec, and also for a Pi
    Zero "shield" (they don't like you calling something a hat unless it's
    actually a hat).
    * A footprint for using a Pi Zero as a daughterboard-style component
    * An M2.5 NPTH footprint used in the templates
    [pi-hat.kicad_pcb, pizero-shield.kicad_pcb]
2017-05-06 Ignore .pro and .kicad_pcb-bak files in the templates directory
2017-05-06 Template PCB updates:
    - Set clearance of 6.2mm diameter (1.72mm additional radius) around
    mounting holes as per hat spec
    - Set all components to "Lock footprint"
    [pi-hat.kicad_pcb, pizero-shield.kicad_pcb]
2017-05-06 Center footprint, mounting hole clearance, speculative 3D model fix
2017-05-08 Add M2.5_MOUNT and use it in the Pi templates
    [pi-hat.kicad_pcb, pizero-shield.kicad_pcb]
2017-05-10 Symbol and footprint for ESP-WROOM-32 module
    As per the datasheet
    [here](https://espressif.com/sites/default/files/documentation/esp_wroom_32_datasheet_en.pdf).
    The ESP32 is quite flexible in that it can remap most alternate
    functions onto any of the pins. So I've decided to only label the
    significant pins on the symbol.
    The datasheet is suprisingly good but it inconsistently refers to the
    exposed pad as pin 1 on the diagram (fig 1) and pin 39 in the table
    (table 2). I've gone with 39.
2017-05-10 Clarify ref&val placement on footprints
2017-05-10 Add fab layer linewidth=0.01mm check to check_mod.py, closes #109
2017-05-10 Further ESP-WROOM-32 footprint tweaks
2017-05-22 A selection of ethernet things
    This includes:
    - Symbol for Microchip LAN8720A ethernet transceiver
    - Yet another slightly different QFN-24 footprint for the above
    - Symbol and footprint for the Amphenol RJMG16x series magjacks
2017-05-23 Correct RXD pin numbering
2017-05-23 Tweak LAN8720A symbol
    This layout is a bit more logical when used in a schematic
2017-05-24 Fix footprint reference
2017-05-28 RJMG footprint tweaks
2017-05-28 Add filter to stickerbom, cleanup xml2bom filter
    Copied the filter functionality from xml2bom to stickerbom and
    simplified the code in the former.
2017-06-05 Add support for double sided boards to StickerBOM
    Modules now render by layer, and PCB render will flip the bottom view. Components present on both sides will split the label.
2017-07-06 Improve TPS62130 pin layout
2017-07-26 Update QFN-64-EP-LTC-UP footprint to avoid paste+mask being over EP vias
2017-08-09 Add S16N-PC 4mm banana receptacle connector
2017-08-09 Add USB-A socket/receptacle
2017-08-09 Update mounting pads on S16N-PC to same net as centre pad
2017-08-20 Add model to LQFP 32 0.8mm pitch
2017-08-20 New STM32F1 parts
    This adds symbols for the 64- and 100-pin variants of the
    STM32F105/107. (For some reason I accidentally thought I wanted
    the 100-pin variant but it's a behemoth.)
    Pin naming is imported from the ISIS files and unmodified except for
    changing NRST to ~RST and reordering.
    I assume the footprints will be as standard but I haven't
    comprehensively checked them...
2017-08-22 STM32F0xxGxUx and QFN-28-ST
2017-08-23 Improved footprint for QFN-28-ST
2017-08-25 Update pin names with alternative uses
2017-11-01 Add AD9218, AD9740, AD8138, AD8041 ADC/DAC and opamps
2017-11-01 add pcb bnc connector 5-1634556-0
2017-12-01 Add 1812 footprint
2018-02-07 added ADP2389 18v, 12A buck converter and also a 12v power symbol
2018-02-07 fixed travis issue 0.15mm silk
2018-02-08 redrew ADP2389 foot print and also added fp for farnell 1848248 WE inductor
2018-02-10 added 30 pin tfml/smfl
2018-02-11 removed trailing space and tweaked adp2389 footprint
2018-02-12 Add STM32F3xxKxTx
2018-02-15 added ultra-fit connector
2018-03-01 added 3v3b and 5vb power sy,bols
2018-03-01 added 100mA 12v LDO and family
2018-07-08 changed power symbols as requested in previous PR
2018-11-04 made changes to footprints as per pr feedback
2018-11-22 Add LPS4018 footprint
2018-11-24 update uqfn-10l footprint and dcm generation
2018-11-24 Add 24V
2019-02-17 Add fuse and polyfuse symbols
2019-02-20 Footprint for F connectors
2019-02-24 Update drill sizes
2019-04-15 Add schematic symbol for 7499210124A and update footprint
2019-04-15 Fix 7499210124A footprint missing NC pins
2019-04-29 Add USB4085 Type-C USB2.0 connector
2019-05-01 Rename pin 3 of DB
2019-05-03 Add Molex-KK footprints
2019-05-27 Update mounting holes on USB4085 to PTH
2019-07-22 Add more power symbols
2019-07-24 Update NCV8460A output pin type
2019-08-17 Add BARRELJACK footprint
2019-08-17 Update barreljack schematic pinout
2019-08-26 Add zener diode
2019-09-20 Add P2_V23079_THT, RELAY_DPDT_2COIL
2019-09-22 Update power lib for negative voltages
2019-09-22 Update power lib for 9v, 10v
2019-11-04 added AD8422, ADR4525, ADP7105 and ADT7420 in addition to AD LFCSP-16 footprint
2019-11-20 added ads1178 ADC
2019-11-25 added 6v5 power symbol and also traco power tel10 module
2019-11-27 changed DOUTx pin type to out
2019-11-30 Move chip/ic footprint definitions to YAML
2020-02-04 flipped tel10 footprint up the right way
2020-04-14 Add STM32F4xxNxHx
2020-04-17 Mark DSI pins on STM32F4xxNxHx
2020-04-17 Mark VDD USB/DSI pins on STM32F4xxNxHx
2020-04-20 Add Molex USB-C connector 105450-0101
2020-04-20 Update USB-C connector pin names and default footprint and order code
2020-04-20 Add JS202011SCQN SMT DPDT switch
2020-04-20 Update pinout for JS202011SCQN for use with switch symbols; remove YAML
2020-04-23 Add SOPA-4 and CD-MBL1xxS diode bridge packages
2020-06-26 Add LFE5U-25F and -45F, and Lattice-BG256 footprint
2020-06-29 Add 25, 32, and 36-pin SIL/DIL 0.1" footprints
2020-06-29 Add 25, 32, and 36-pin connector symbols
2020-07-12 Add BGA footprint building, regenerate existing BGAs
2020-07-15 Check duplicate non-numeric pin numbers
2020-07-15 Add 1v1 power symbol
2020-07-25 Add WSON-8 Flash footprint
2020-07-28 Fix footprint reference for SK27KL0641
2021-01-04 Add STM32G0xxKx symbol
2021-02-28 added ZSR series regulator
2021-02-28 Update SOT-223 footprint to match IPC-7351
2021-05-23 Use LED designator for WS2812B-4020
2021-05-23 Update WS2812B-4020 footprint to centre component centroid
2021-05-23 Add STM32F411VETx
2021-05-23 Add momentary tact switch footprint
2021-11-02 Add 22-pin connectors
2021-11-02 Generate all connectors up to 25 inclusive
2021-11-11 Add CELL symbol and KEYSTONE_103 battery holder footprint.
2021-11-12 Add NN01-103 footprint
2022-07-13 Port build_lib_connector to kicad6 file format
2022-07-14 Port build_lib_ic to kicad6 format
2022-07-14 Port build_lib_power to kicad6 format
2022-07-15 Migrate to .kicad_pro project file
2022-07-15 Remove legacy libs from kicad_pro
2022-07-15 Update makefile to use kicad_sym filenames
2022-07-15 Port build_lib_switch to kicad6 format
2022-07-15 Port check_lib to kicad6 format
2022-07-18 Update compile_lib and compile_sym_lib_table for new kicad6 file format
2022-07-18 Swap all libraries over to kicad6 format
2022-07-19 Update docs for kicad_sym instead of lib
2022-08-17 Update most SMD footprints to be SMD type, and virtual footprints to be virtual.
2022-08-17 Also make BGAs SMD and mounting holes and SJs virtual
2022-10-18 Update stickerbom for kicad 6.0
2023-01-11 Add R40N-3021-85-1012 and relay_no
2023-01-12 Add footprints 38700-7504 and MOV_7.5mm
2023-01-12 Fix pin numbering on R40N-3021-85-1012
2023-01-12 Fix pin numbering on MOV_7.5mm
2023-01-29 Add OPA455 and SOIC-8-PowerPAD
2023-01-29 Update MSOP-10-EP-LT footprint
2023-01-29 Add stm32g4xxkx
2023-01-30 Add stm32g4xxux
2023-01-30 Add USB-C vertical footprint 2171820001
2023-02-02 Fix EP vias on WSON-8-EP-TI and SOIC-8-PowerPAD, update courtyard on R40N-3021-85-1012 and 2171820001
2024-02-20 add stm32h750vxtx
2024-02-22 add pulse-j1
    [J1011F01PNL_3D.STEP]
2024-02-24 shift origin of pj-327c-4a to match jlc pcba
2024-02-25 add switch_mom_spst_4p
2024-02-26 Add EP pin to NAU88C22YG
2024-03-29 add 0603 diodes to set3d
2024-03-29 update set3d to use pcbnew api and work with kicad8
2024-03-31 update 3d model paths for kicad8
2025-01-08 add fdc2x1x, tmux111x, stm32g4xxcxtx
2025-09-02 add EP pin to lm5148 sym
